ek-team/pump/版本说明.txt

AtmsG 第一代 目前正在量产的机器 HR02系列 单泵 单传感器
AtmsW 第二代 安徽注册机器 HA系列 双泵 单传感器
AtmsS 第三代  双泵 五路传感器
