ek-team/pump/HR02气路图.pdf

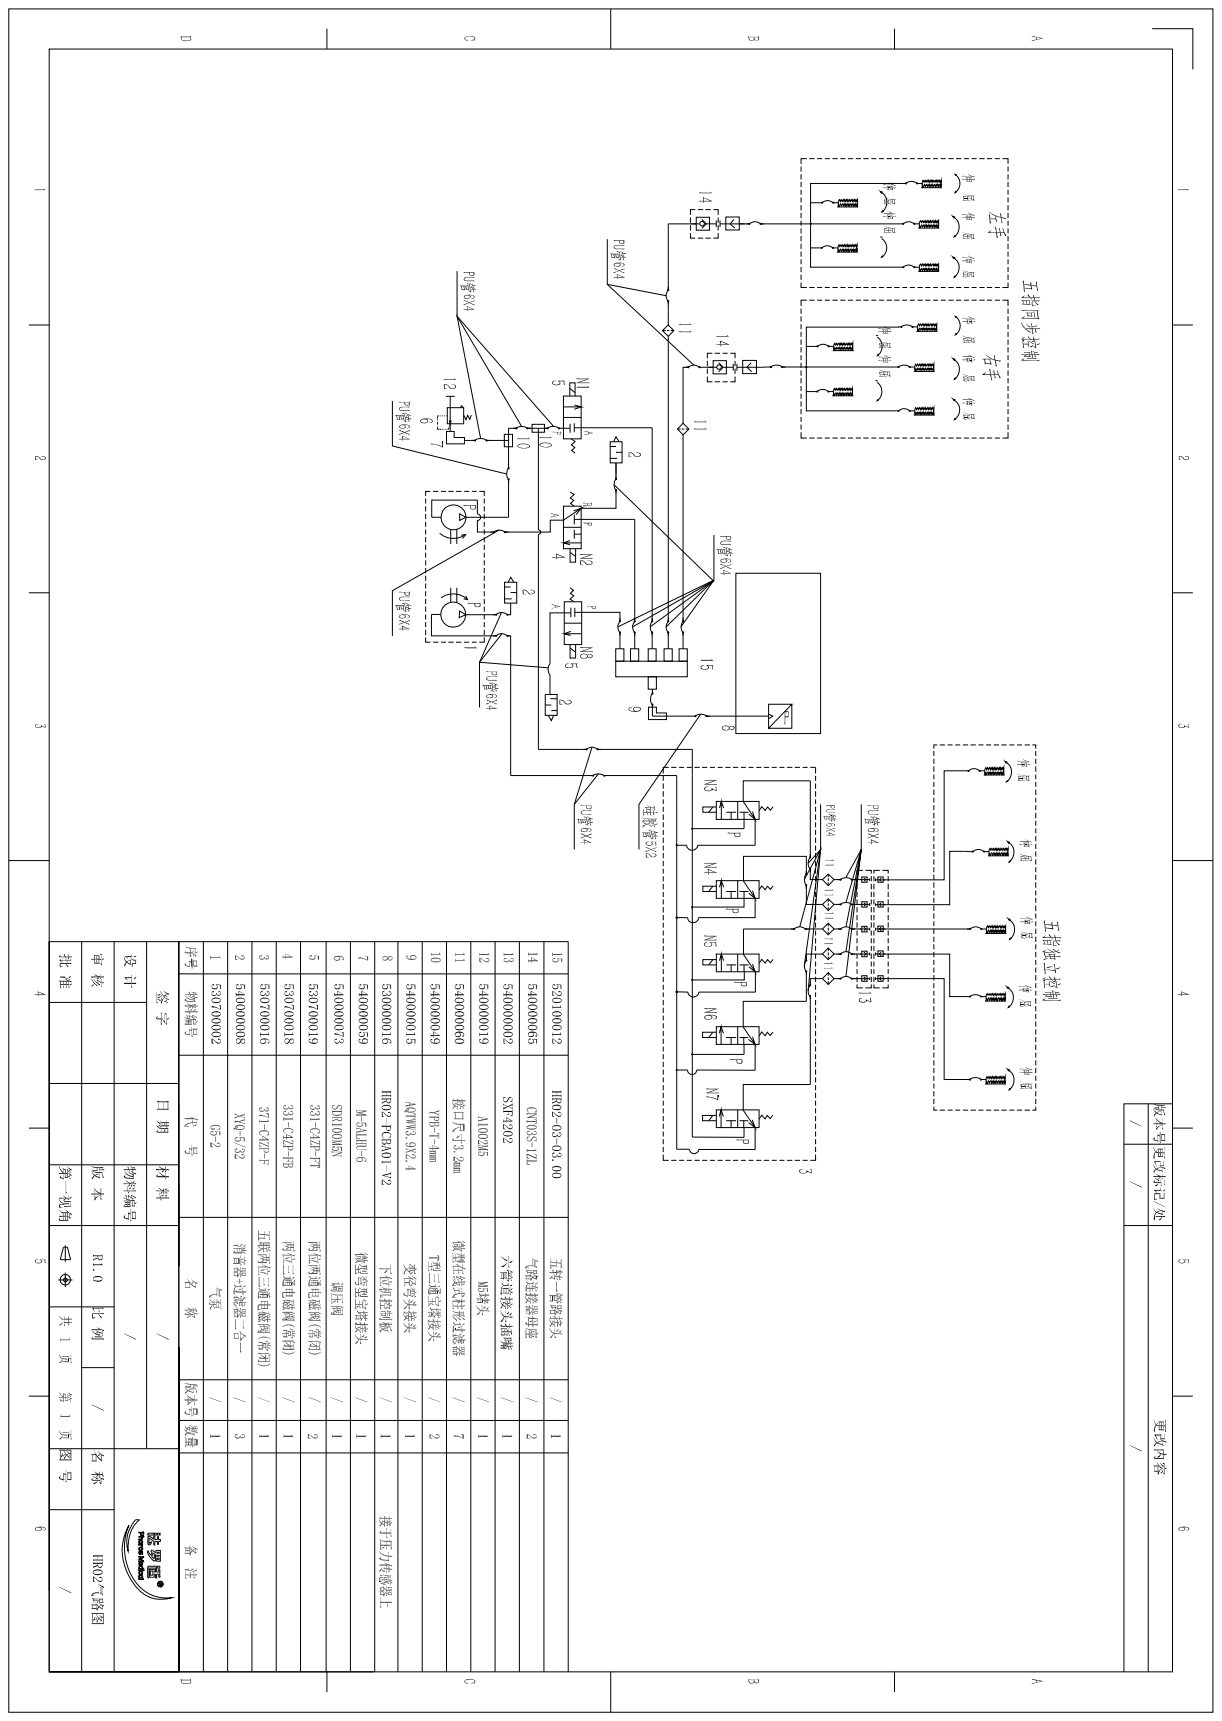
[picture p1: page 1]
