ek-team/pump/AtmsG/AtmsCtrl/IAP/User/APP/Inc/main.h

#ifndef __MAIN_H
#define __MAIN_H

#include "stm32f1xx_hal.h"
#include "usart.h"
#include "flash.h"
#include "iap.h"
#include "tim.h"
#include "htx.h"
#include "gpio.h"

extern uint8_t U1_RxData;

#endif
