ek-team/pump/AtmsG/AtmsCtrl/User/APP/Inc/main.h

#ifndef __MAIN_H
#define __MAIN_H

//APPͷ�ļ�
#include "sys.h"

//BSPͷ�ļ�
#include "gpio.h"
#include "usart.h"
#include "tim.h"
#include "adc.h"

//FreeRTOSͷ�ļ�
#include "FreeRTOS.h"
#include "task.h"
#include "queue.h"
#include "semphr.h"
#include "event_groups.h"

#endif
