ek-team/pump/AtmsG/AtmsCtrl/IAP/User/BSP/Src/flash.c

#include "flash.h"

#if STM32_FLASH_SIZE < 256
  #define STM_SECTOR_SIZE  1024                        //字节
#else 
  #define STM_SECTOR_SIZE	 2048
#endif

#if STM32_FLASH_WREN	                                 //如果写使能
static uint16_t STMFLASH_BUF[STM_SECTOR_SIZE/2];       //最大2K字节
static FLASH_EraseInitTypeDef EraseInitStruct;
#endif

uint16_t STMFLASH_ReadHalfWord(uint32_t faddr)         //读取指定地址的半字(16位数据),读地址(此地址必须为2的倍数!)
{
	return *(__IO uint16_t*)faddr; 
}

#if STM32_FLASH_WREN	                                 //如果写使能
void STMFLASH_Write_NoCheck(uint32_t WriteAddr,uint16_t *pBuffer,uint16_t NumToWrite)  //不检查的写入,NumToWrite:半字(16位)数
{ 			 		 
	uint16_t i;
	for(i=0;i<NumToWrite;i++)
	{
		HAL_FLASH_Program(FLASH_TYPEPROGRAM_HALFWORD,WriteAddr,pBuffer[i]);
	  WriteAddr += 2;                                    //地址增加2
	}  
} 

void STMFLASH_Write(uint32_t WriteAddr,uint16_t *pBuffer,uint16_t NumToWrite)	
{
  uint32_t SECTORError = 0;
	uint16_t secoff;	                                   //扇区内偏移地址(16位字计算)
	uint16_t secremain;                                  //扇区内剩余地址(16位字计算)	   
 	uint16_t i;    
	uint32_t secpos;	                                   //扇区地址
	uint32_t offaddr;                                    //去掉0X08000000后的地址
	
	if(WriteAddr < FLASH_BASE||(WriteAddr >= (FLASH_BASE + 1024*STM32_FLASH_SIZE)))return;//非法地址
	
	HAL_FLASH_Unlock();						                       //解锁
	offaddr = WriteAddr - FLASH_BASE;		                 //实际偏移地址.
	secpos = offaddr/STM_SECTOR_SIZE;			               //扇区地址0~127 for STM32F103RBT6
	secoff = (offaddr%STM_SECTOR_SIZE)/2;		             //在扇区内的偏移(2个字节为基本单位.)
	secremain = STM_SECTOR_SIZE/2-secoff;		             //扇区剩余空间大小   
	if(NumToWrite <= secremain) secremain = NumToWrite;  //不大于该扇区范围
	
	while(1) 
	{	
		STMFLASH_Read(secpos*STM_SECTOR_SIZE+FLASH_BASE,STMFLASH_BUF,STM_SECTOR_SIZE/2);//读出整个扇区的内容
		for(i=0;i<secremain;i++)                           //校验数据
		{
			if(STMFLASH_BUF[secoff+i]!=0XFFFF)break;         //需要擦除  	  
		}
		if(i<secremain)                                    //需要擦除
		{
      EraseInitStruct.TypeErase = FLASH_TYPEERASE_PAGES;//擦除这个扇区
      EraseInitStruct.PageAddress = secpos*STM_SECTOR_SIZE+FLASH_BASE;
      EraseInitStruct.NbPages = 1;
      HAL_FLASHEx_Erase(&EraseInitStruct, &SECTORError);

			for(i=0;i<secremain;i++)                         //复制
			{
				STMFLASH_BUF[i+secoff] = pBuffer[i];	  
			}
			STMFLASH_Write_NoCheck(secpos*STM_SECTOR_SIZE+FLASH_BASE,STMFLASH_BUF,STM_SECTOR_SIZE/2);//写入整个扇区  
		}
    else
    {
      STMFLASH_Write_NoCheck(WriteAddr,pBuffer,secremain);//写已经擦除了的,直接写入扇区剩余区间			   
		}
    if(NumToWrite == secremain)break;                  //写入结束
		else                                               //写入未结束
		{
			secpos++;				                                 //扇区地址增1
			secoff = 0;				                               //偏移位置为0 	 
		  pBuffer += secremain;  	                         //指针偏移
			WriteAddr += secremain;	                         //写地址偏移	   
		  NumToWrite -= secremain;	                       //字节(16位)数递减
			if(NumToWrite>(STM_SECTOR_SIZE/2)) secremain = STM_SECTOR_SIZE/2; //下一个扇区还是写不完
			else secremain = NumToWrite;                     //下一个扇区可以写完了
		}	 
	};	
	HAL_FLASH_Lock();                                    //上锁
}
#endif

void STMFLASH_Read(uint32_t ReadAddr,uint16_t *pBuffer,uint16_t NumToRead) //从指定地址开始读出指定长度的数据,NumToRead:半字(16位)数
{
	uint16_t i;
	for(i=0;i<NumToRead;i++)
	{
		pBuffer[i] = STMFLASH_ReadHalfWord(ReadAddr);      //读取2个字节
		ReadAddr += 2;                                     //偏移2个字节
	}
}
