ek-team/pump/AtmsS/AtmsCtrl/User/BSP/Src/modbus.c

#include "modbus.h"

void MB_ReadOneReg_03H(uint8_t addr, uint16_t reg, uint16_t num)//读单个寄存器
{
	static uint8_t TxBuf[MAX_TX_SIZE];
	uint16_t index = 0;
  uint16_t crc = 0;
	TxBuf[index++] = addr;
	TxBuf[index++] = 0x03;
	TxBuf[index++] = reg >> 8;
	TxBuf[index++] = reg;
	TxBuf[index++] = num >> 8;
	TxBuf[index++] = num;

	crc = MB_CRC16((uint8_t*)&TxBuf,index);
  TxBuf[index++] = crc;
	TxBuf[index++] = crc>>8;
  BSP_U1_Tx((uint8_t *)&TxBuf,index);
}

void MB_ReadNumReg_04H(uint8_t addr, uint16_t reg, uint16_t num) //读多个寄存器
{
  static uint8_t TxBuf[MAX_TX_SIZE];
	uint16_t index = 0;
  uint16_t crc = 0;
	TxBuf[index++] = addr;
	TxBuf[index++] = 0x04;
	TxBuf[index++] = reg >> 8;
	TxBuf[index++] = reg;
	TxBuf[index++] = num >> 8;
	TxBuf[index++] = num;

	crc = MB_CRC16((uint8_t*)&TxBuf,index);
  TxBuf[index++] = crc;
	TxBuf[index++] = crc>>8;
  BSP_U1_Tx((uint8_t *)&TxBuf,index);
}

void MB_WriteOneReg_06H(uint8_t addr, uint16_t reg, uint16_t data) //写单个寄存器
{
  static uint8_t TxBuf[MAX_TX_SIZE];
	uint16_t index = 0;
  uint16_t crc = 0;
	TxBuf[index++] = addr;
	TxBuf[index++] = 0x06;
	TxBuf[index++] = reg >> 8;
	TxBuf[index++] = reg;
	TxBuf[index++] = data >> 8;
	TxBuf[index++] = data;

	crc = MB_CRC16((uint8_t*)&TxBuf,index);
  TxBuf[index++] = crc;
	TxBuf[index++] = crc>>8;
  BSP_U1_Tx((uint8_t *)&TxBuf,index);
}

void MB_WriteNumReg_10H(uint8_t addr, uint16_t reg, uint16_t num,uint8_t *databuf)//写多个寄存器
{
  static uint8_t TxBuf[MAX_TX_SIZE];
  uint16_t i;
	uint16_t index = 0;
  uint16_t crc = 0;
	TxBuf[index++] = addr ;		    //从站地址
	TxBuf[index++] = 0x10;		    //功能码
	TxBuf[index++] = reg >> 8;	  //寄存器地址 高字节
	TxBuf[index++] = reg;		      //寄存器地址 低字节
	TxBuf[index++] = num >> 8;	  //寄存器(16bits)个数 高字节
	TxBuf[index++] = num;		      //寄存器(16bits)个数 低字节
  TxBuf[index++] = num << 1;		//数据个数

  for (i=0;i<2*num;i++)
  {
		TxBuf[index++] = databuf[i];//后面的数据长度
	}
	crc = MB_CRC16((uint8_t*)&TxBuf,index);
  TxBuf[index++] = crc;	        //CRC低字节
	TxBuf[index++] = crc>>8;		  //CRC高字节
  BSP_U1_Tx((uint8_t *)&TxBuf,index);
}

//CRC高位字节值表
static const uint8_t CRC_H[] = {
    0x00, 0xC1, 0x81, 0x40, 0x01, 0xC0, 0x80, 0x41, 0x01, 0xC0,
    0x80, 0x41, 0x00, 0xC1, 0x81, 0x40, 0x01, 0xC0, 0x80, 0x41,
    0x00, 0xC1, 0x81, 0x40, 0x00, 0xC1, 0x81, 0x40, 0x01, 0xC0,
    0x80, 0x41, 0x01, 0xC0, 0x80, 0x41, 0x00, 0xC1, 0x81, 0x40,
    0x00, 0xC1, 0x81, 0x40, 0x01, 0xC0, 0x80, 0x41, 0x00, 0xC1,
    0x81, 0x40, 0x01, 0xC0, 0x80, 0x41, 0x01, 0xC0, 0x80, 0x41,
    0x00, 0xC1, 0x81, 0x40, 0x01, 0xC0, 0x80, 0x41, 0x00, 0xC1,
    0x81, 0x40, 0x00, 0xC1, 0x81, 0x40, 0x01, 0xC0, 0x80, 0x41,
    0x00, 0xC1, 0x81, 0x40, 0x01, 0xC0, 0x80, 0x41, 0x01, 0xC0,
    0x80, 0x41, 0x00, 0xC1, 0x81, 0x40, 0x00, 0xC1, 0x81, 0x40,
    0x01, 0xC0, 0x80, 0x41, 0x01, 0xC0, 0x80, 0x41, 0x00, 0xC1,
    0x81, 0x40, 0x01, 0xC0, 0x80, 0x41, 0x00, 0xC1, 0x81, 0x40,
    0x00, 0xC1, 0x81, 0x40, 0x01, 0xC0, 0x80, 0x41, 0x01, 0xC0,
    0x80, 0x41, 0x00, 0xC1, 0x81, 0x40, 0x00, 0xC1, 0x81, 0x40,
    0x01, 0xC0, 0x80, 0x41, 0x00, 0xC1, 0x81, 0x40, 0x01, 0xC0,
    0x80, 0x41, 0x01, 0xC0, 0x80, 0x41, 0x00, 0xC1, 0x81, 0x40,
    0x00, 0xC1, 0x81, 0x40, 0x01, 0xC0, 0x80, 0x41, 0x01, 0xC0,
    0x80, 0x41, 0x00, 0xC1, 0x81, 0x40, 0x01, 0xC0, 0x80, 0x41,
    0x00, 0xC1, 0x81, 0x40, 0x00, 0xC1, 0x81, 0x40, 0x01, 0xC0,
    0x80, 0x41, 0x00, 0xC1, 0x81, 0x40, 0x01, 0xC0, 0x80, 0x41,
    0x01, 0xC0, 0x80, 0x41, 0x00, 0xC1, 0x81, 0x40, 0x01, 0xC0,
    0x80, 0x41, 0x00, 0xC1, 0x81, 0x40, 0x00, 0xC1, 0x81, 0x40,
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
	0x43, 0x83, 0x41, 0x81, 0x80, 0x40
};

uint16_t MB_CRC16(uint8_t *Msg,uint8_t Len)
{
  uint8_t CRCH = 0xFF;
  uint8_t CRCL = 0xFF;
  uint16_t Index;
  while(Len--)
  {
    Index = CRCL ^ *Msg++;
    CRCL = CRCH^CRC_H[Index];
    CRCH = CRC_L[Index];
  }
  return (CRCH<<8|CRCL);
}
