ek-team/pump/AtmsG/AtmsCtrl/User/APP/Inc/ctl.h

#ifndef __CTL_H
#define __CTL_H

#include "sys.h"

void CTL0(void);
void CTL1(void);
void CTL2(void);
void CTL3(void);
void CTL4(void);
void CTL5(void);
void CTL6(void);
void CTL7(void);
void CTL8(void);
void CTL9(void);
void CTL10(void);
void CTL11(void);
void CTL12(void);
void CTL13(void);
void CTL14(void);
void CTL15(void);
void CTL16(void);
void CTL17(void);
void Escape(uint8_t EN);
void Pump(uint8_t IO);

#endif
